ttsiodras/ATtiny85_currentMeter/(threads)

Thread 1 (2020-07-02):

Schematic

colesnicov, 2020-07-02:
Hello, It's look good. You can provide Schematic? please.

ttsiodras, 2020-07-02:
Hi. This was a very simple circuit, so I just breadboarded it and then transferred it to perfboard. The closest I have to a schematic is the extensive documentation I wrote inside the comments - here: https://github.com/ttsiodras/ATtiny85_currentMeter/blob/master/Attiny85CurrentMeter.ino#L2 - have a look.

Closed 2020-07-03.
