ttsiodras/ATtiny85_currentMeter/Emiter.ino

#include "Emiter.h"

#include "globals.h"

void Emiter::printChar(char c) 
{
    if (columnNo < sizeof(msgBuf)-1)
        msgBuf[columnNo++] = c;
}

void Emiter::printString(const char *src) 
{
    size_t i, n=sizeof(msgBuf)-columnNo-1;
    for (i=0; i<n && src[i] != '\0'; i++)
        msgBuf[columnNo + i] = src[i];
    columnNo += i;
}

void Emiter::printInt(
    int i,             // input value
    bool sign,         // whether the value can be negative (i.e. %d vs %u)
    bool padded,       // whether the value should be padded
    int padwidth,      // number of digits to pad (%3d)
    int base,          // what's the numeric base i.e. %d (10) vs %x (16)
    int letbase)       // for hex nibbles (%x or %X) what is the baseline character
{
    static char print_buf[sizeof(msgBuf)];
    char *s;
    int pc = 0;
    bool neg = false;
    unsigned int u = i;

    if (i == 0) {
        i = padded?padwidth:1;
        do { printChar('0'); } while(--i);
        return;
    }

    if (sign && base==10 && i<0) {
        neg = true;
        u = -i;
    }

    s = print_buf + sizeof(msgBuf) - 1;
    *s = '\0';

    while (u) {
        int t = u % base;
        if (t >= 10)
            t += letbase - '0' - 10;
        *--s = t + '0';
        pc++;
        u /= base;
    }

    if (neg) {
        *--s = '-';
        pc++;
    }

    if (padded)
        while(pc++ < padwidth)
            printChar('0');

    printString(s);
}

Emiter::~Emiter()
{
    while(columnNo < sizeof(msgBuf))
        msgBuf[columnNo++] = ' ';
    msgBuf[sizeof(msgBuf)-1] = 0;
    oled.cursorTo(0, lineNo++);
    oled.printString(msgBuf);
    mySerial.println(msgBuf);
    columnNo = 0;
}

char Emiter::msgBuf[16] = {0};
int Emiter::lineNo = 0;
unsigned Emiter::columnNo = 0;
