ttsiodras/ATtiny85_currentMeter/globals.h

#ifndef __GLOBALS_H__
#define __GLOBALS_H__

//////////////////////////////////////////
// Software serial for long-term recording
//////////////////////////////////////////
#include <SendOnlySoftwareSerial.h>

SendOnlySoftwareSerial mySerial(PB3);

#endif
