ttsiodras/ATtiny85_currentMeter/(commit log)

2019-12-14 Tested, on powered external USB3 hub and various other test loads. Works!
2019-12-22 Sleep for ~80 seconds, report current for 5 seconds.
2019-12-22 Add 'make print-*' rule, to assist makefile debugging.
2021-07-18 USI(HW-I2C) OLED - from 89% down to 71% flash use.
2021-07-18 Make updates accurate: Print one measurement per second.
2021-07-18 Lowest posible power usage
    - 1MHz clock, not 8MHz
    - ...and a 2N3904 conneted to PB1 to power off the screen completely during sleep.
